ittalopezzotti/ittalopezzotti.copagetec.github.io/Img/Image_Copagetec_Closed_System_Conceptual_Idea.png

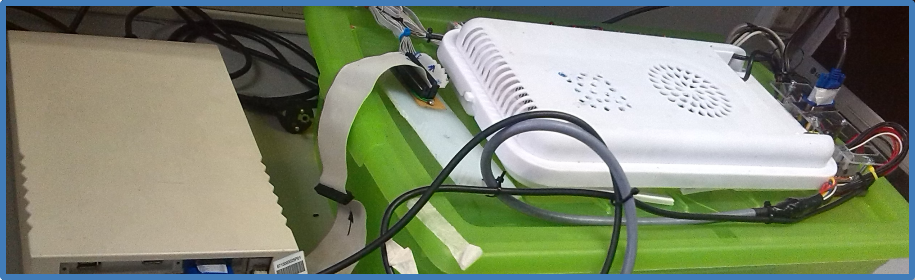
Img/Image_Copagetec_Closed_System_Conceptual_Idea.png
