ittalopezzotti/ittalopezzotti.copagetec.github.io/Img/Image_Copagetec_Conceptual_Proposal.png

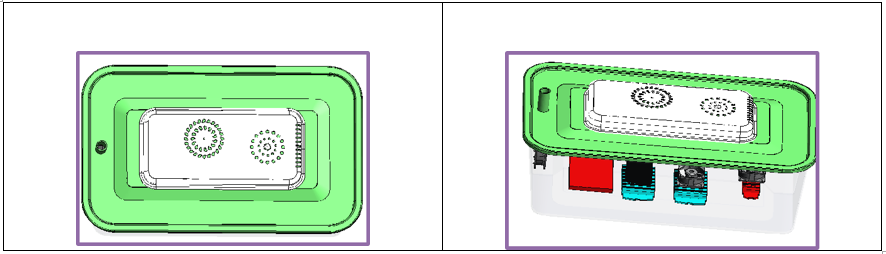
Img/Image_Copagetec_Conceptual_Proposal.png
