ittalopezzotti/ittalopezzotti.copagetec.github.io/Img/Image_Copagetec_Container_System_Elements .png

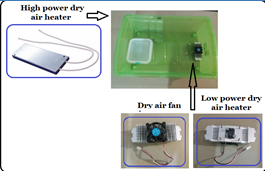
Img/Image_Copagetec_Container_System_Elements .png
