ittalopezzotti/ittalopezzotti.copagetec.github.io/Img/Image_Copagetec_Energy _Balance .png

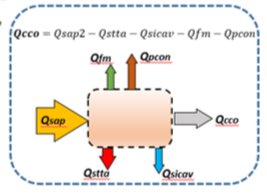
Img/Image_Copagetec_Energy _Balance .png
