ittalopezzotti/ittalopezzotti.copagetec.github.io/Img/Image_Copagetec_Table 3_Data_Relating_Conceptual_Idea.png

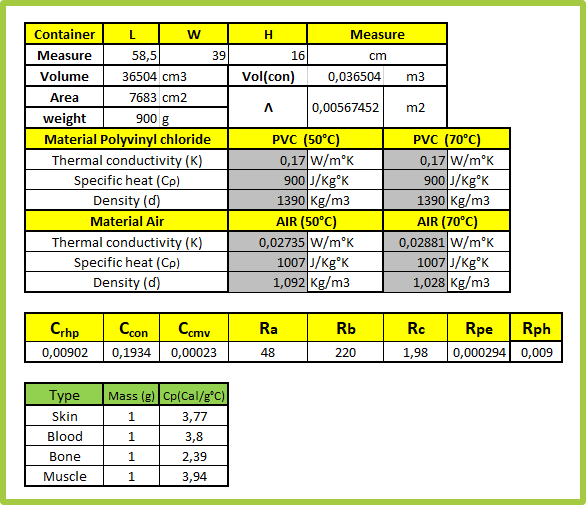
Img/Image_Copagetec_Table 3_Data_Relating_Conceptual_Idea.png
