ittalopezzotti/ittalopezzotti.copagetec.github.io/Img/Image_Copagetec_Transfer_functions .png

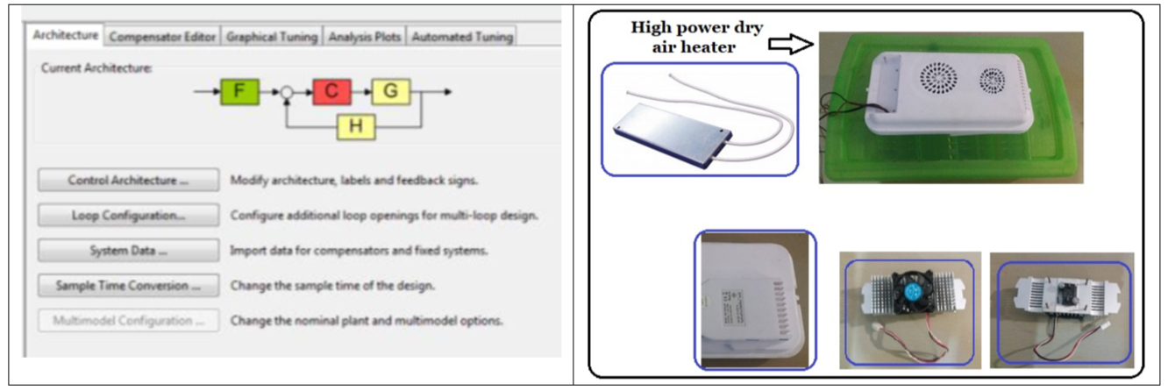
Img/Image_Copagetec_Transfer_functions .png
