ittalopezzotti/ittalopezzotti.copagetec.github.io/Img/Table_2_Teorical_Model.png

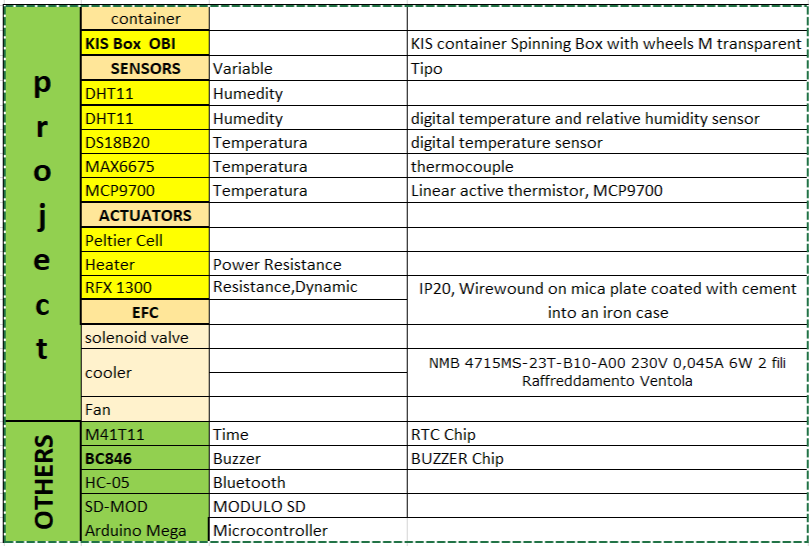
Img/Table_2_Teorical_Model.png
