ittalopezzotti/ittalopezzotti.copagetec.github.io/Eagle_Schematic_Copagetec_Project.pdf

## LEDS SYSTEM CONTROLLERREAL TIME CLOCK M41T11

# Eagle_Cacote_Copagetec.sch

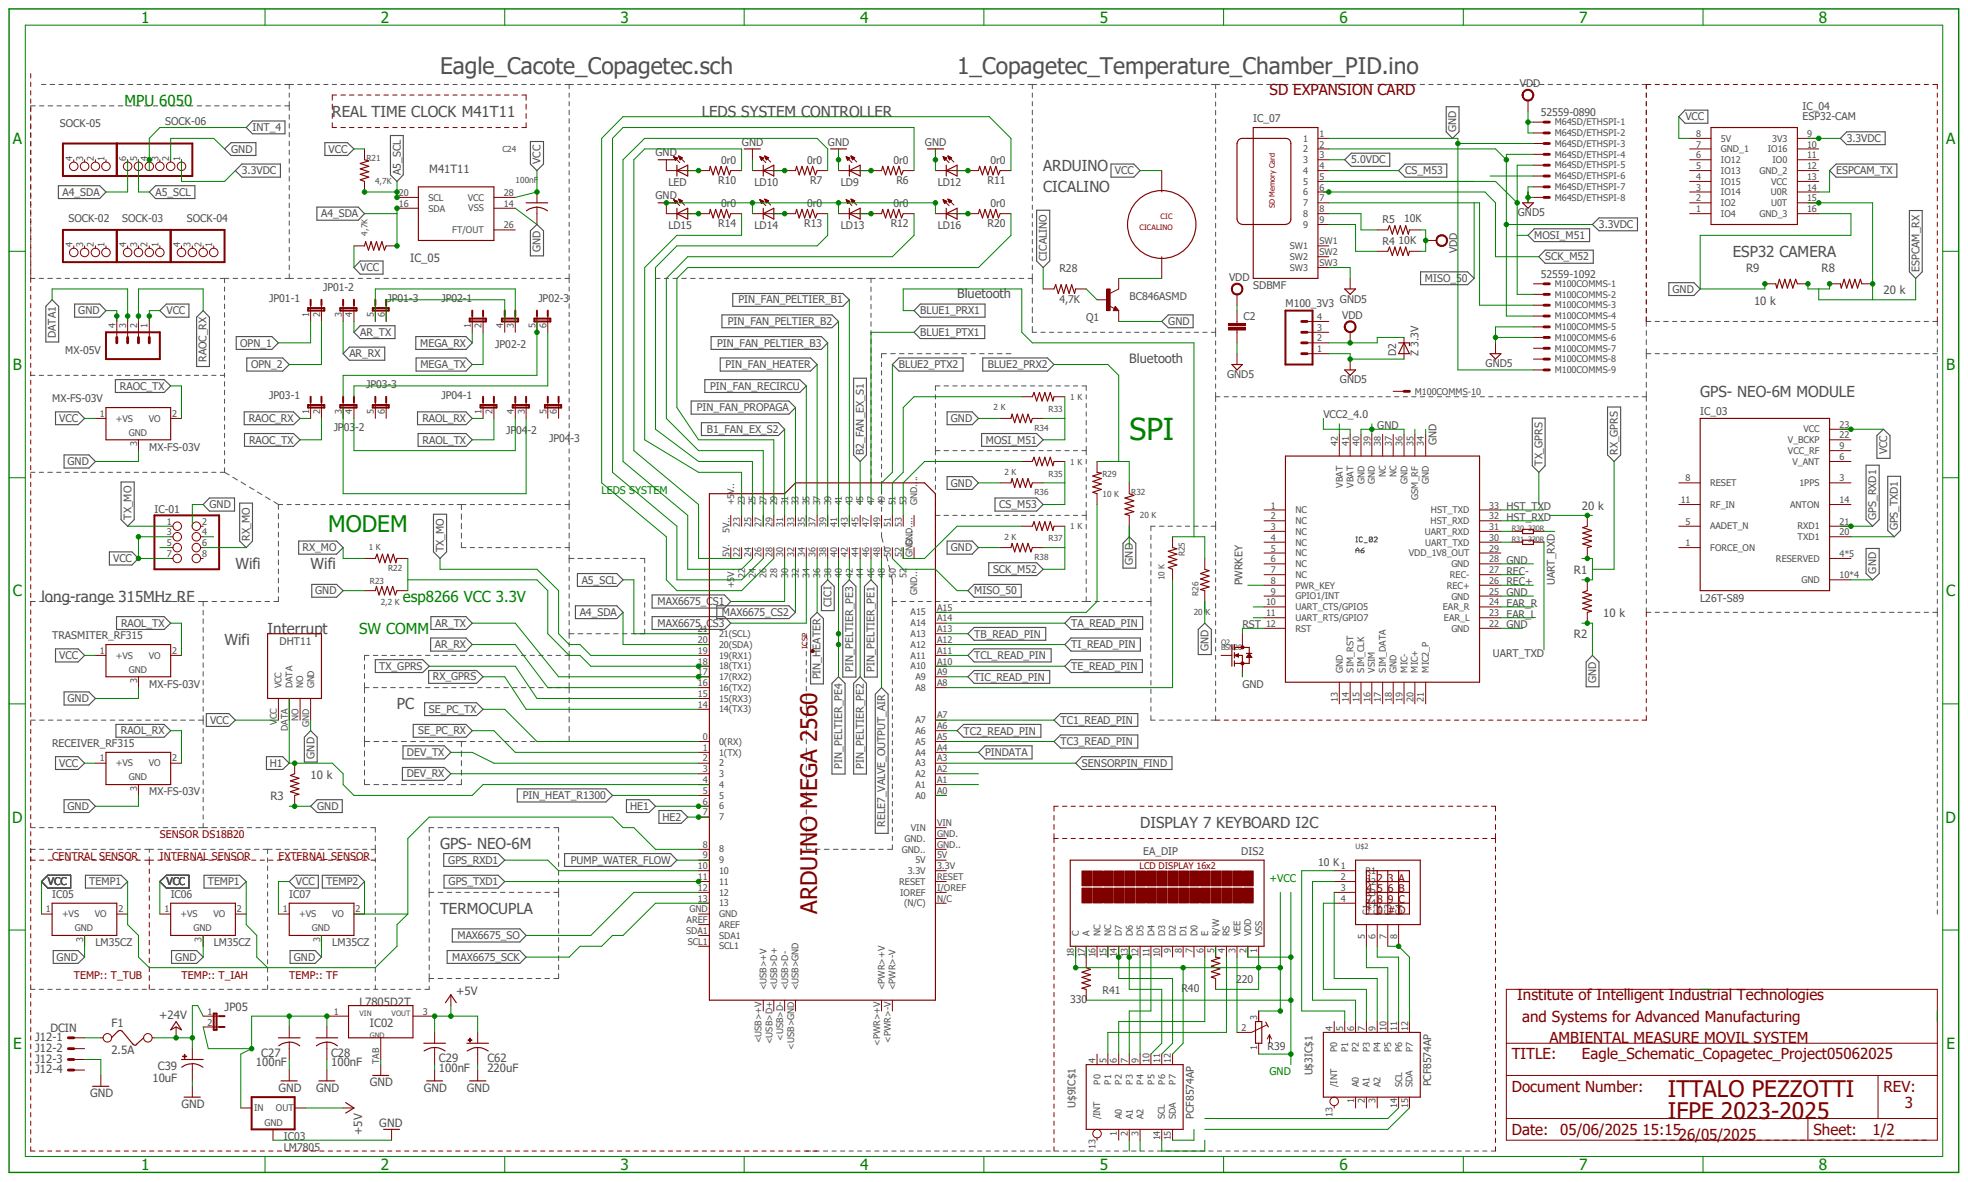
[picture p12: page 1]

Institute of Intelligent Industrial Technologies
and Systems for Advanced Manufacturing
AMBIENTAL MEASURE MOVIL SYSTEM

Document Number: ITTALO PEZZOTTI IFPE 2023-2025 | REV: 3

Date: 05/06/2025 15:15 26/05/2025 | Sheet: 1/2
