ittalopezzotti/ittalopezzotti.copagetec.github.io/Eagle_Schematic_Copagetec_Project.sch

## EAGLE design Eagle_Schematic_Copagetec_Project.sch (2025-06-05)

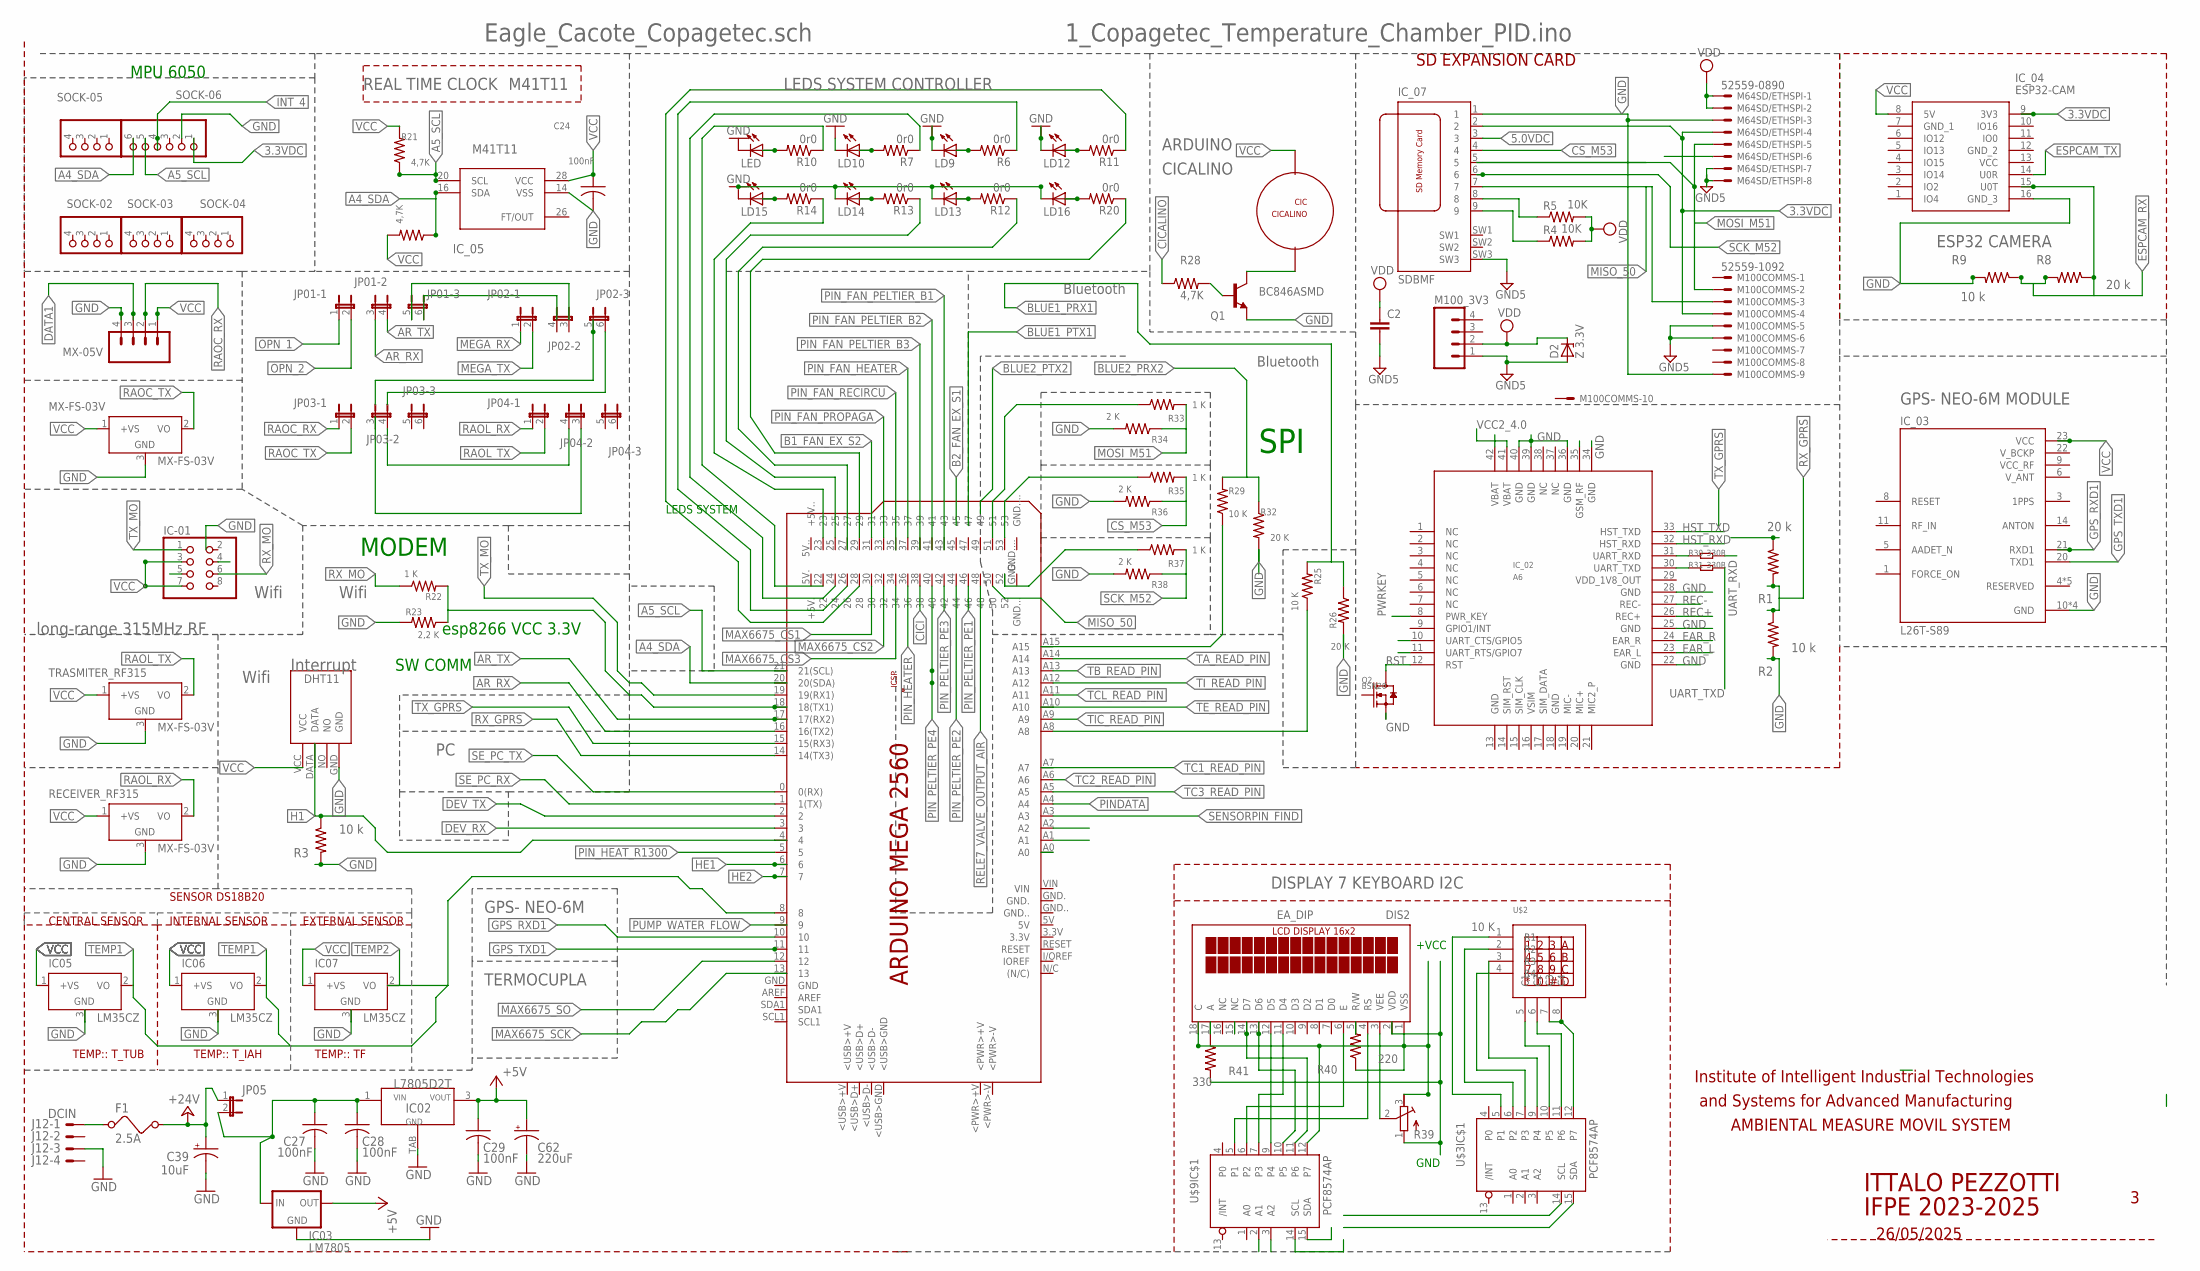
[picture p13: schematic Eagle_Schematic_Copagetec_Project.sch, sheet 1]

Parts:
C2: 100nF; C0805K@1
C24, C27, C28, C29: 100nF; C0805
C39: 10uF; C/6032-28R
C62: 220uF; 153CLV-0605
CICALINO: CIC
D2: Z 3.3V; SMB
DIS2: EA_DIP
F1: 2.5A; FUSE
IC02: L7805D2T; TO263-2
IC03: LM7805; 78XXS
IC05, IC06, IC07: LM35CZ; TO92
IC-01: PINHD-2X4; 2X04
IC_02: A6
IC_03: L26T-S89; XCVR_L26T-S89
IC_04: ESP32-CAM
IC_05: M41T11; SOH28
IC_07: SDBMF; SDBMF-009XXBXX2
J12: DCIN; PANDUIT_2.54X4
JP01, JP02, JP03, JP04: JP3QE; JP3Q
JP05: JP1E; JP1
LD9, LD10, LD12, LD13, LD14, LD15, LD16: LED3MM
LED: LED3MM
M64SD/ETHSPI: 52559-0890
M100COMMS: 52559-1092
M100_3V3: M04; 04P
MX-05V: M04; 04P
MX-FS-03V: MX-FS-03V; TO92
PCB1: ARDUINO_MEGA2560
Q1: BC846ASMD; SOT23
Q2: BSN20; SOT23@1
R1, R8: 20 k; M0805
R2, R3, R9: 10 k; M0805
R4, R5: 10K; M0805
R6, R7, R10, R11, R12, R13, R14, R20: 0r0; M0805
R21, R27, R28: 4,7K; M0805
R22, R33, R35, R37: 1 K; M0805
R23: 2,2 K; M0805
R25, R29: 10 K; M0805
R26, R32: 20 K; M0805
R30, R31: 330R; R0603
R34, R36, R38: 2 K; M0805
R39: 10 K; RTRIM64W
R40: 220; 0309/10
R41: 330; 0309/10
RECEIVER_RF315: MX-FS-03V; TO92
SOCK-02, SOCK-03, SOCK-04, SOCK-05: PINHD-1X4; 1X04
SOCK-06: PINHD-1X6_2.00; 1X06M
TRASMITER_RF315: MX-FS-03V; TO92
U$2: KEYPAD4X4
U$3, U$9: PCF8574AP; DIL16
U$12: DHT11

Connections:
3.3VDC: IC_04.9 (3V3), IC_07.2, M64SD/ETHSPI.4, M100COMMS.4, SOCK-06.1
5.0VDC: IC_07.3
+5V: C29.1, C62.+, IC02.3 (VOUT), IC03.OUT
+24V: C39.+, F1.2, JP05.1
A4_SDA: IC_05.16 (SDA), PCB1.20 (20(SDA)), R27.1, SOCK-06.6
A5_SCL: IC_05.20 (SCL), PCB1.21 (21(SCL)), R21.1, SOCK-06.5
ARME_M51: R33.1
ARME_M52: PCB1.52, R37.1
ARME_M53: R35.1
AR_RX: JP01.3 (1), PCB1.16 (16(TX2))
AR_TX: JP01.4 (2), PCB1.17 (17(RX2))
BLUE1_PRX1: R25.2, R26.1
BLUE2_PRX2: R29.2, R32.1
CICALINO: R28.1
CS_M53: IC_07.4, R35.2, R36.1
DATA1: MX-05V.3
DEV_RX: PCB1.3
DEV_TX: PCB1.2
EAR_L: IC_02.23 (EAR_L)
EAR_R: IC_02.24 (EAR_R)
ESPCAM_RX: IC_04.15 (U0T), R8.1, R8.2, R9.1
ESPCAM_TX: IC_04.14 (U0R)
GND: C24.2, C27.2, C28.2, C29.2, C39.-, C62.-, IC02.TAB (GND), IC03.GND, IC05.3 (GND), IC06.3 (GND), IC07.3 (GND), IC_02.22 (GND), IC_02.25 (GND), IC_02.28 (GND), IC_02.34 (GND), IC_02.36 (GND), IC_02.39 (GND), IC_02.40 (GND), IC_03.10 (GND), IC_04.16 (GND_3), IC_05.14 (VSS), IC_07.1, J12.3, LD10.K (C), LD15.K (C), LED.K (C), M64SD/ETHSPI.3, M100COMMS.9, MX-05V.4, MX-FS-03V.3 (GND), Q1.2 (E), Q2.2 (S), R9.2, R23.2, R26.2, R32.2, RECEIVER_RF315.3 (GND), SOCK-06.2, TRASMITER_RF315.3 (GND), U$12.GND
GND5: C2.2, D2.A, IC_07.SW3, M64SD/ETHSPI.7, M64SD/ETHSPI.8, M100COMMS.5, M100COMMS.6, M100_3V3.1
GPS_RXD1: IC_03.21 (RXD1), PCB1.10
GPS_TXD1: IC_03.20 (TXD1), PCB1.11
GSM_RF: IC_02.35 (GSM_RF)
H1: PCB1.4, R3.1, U$12.DATA
HE1: PCB1.6
HE2: PCB1.7
HST_RXD: IC_02.32 (HST_RXD)
HST_TXD: IC_02.33 (HST_TXD)
INT_4: SOCK-06.4
MAX6675_SCK: PCB1.13
MAX6675_SO: PCB1.12
MEGA_RX: JP02.1
MEGA_TX: JP02.2
MISO_50: IC_07.7, M100COMMS.3
MOSI_M51: M64SD/ETHSPI.5, M100COMMS.2, R33.2, R34.1
unnamed: F1.1, J12.1
unnamed: IC_02.31 (UART_RXD), R30.1
unnamed: IC_02.30 (UART_TXD), R31.1
unnamed: R1.2, R2.1
unnamed: IC_07.8, R5.1
unnamed: IC_07.9, R4.1
unnamed: Q1.1 (B), R28.2
unnamed: LD9.A, R6.2
unnamed: CICALINO.P$1, Q1.3 (C)
unnamed: LD10.A, R7.2
unnamed: LED.A, R10.2
unnamed: LD12.A, R11.2
unnamed: LD13.A, R12.2
unnamed: PCB1.27, R12.1
unnamed: JP03.4 (2), JP04.4 (2)
unnamed: JP03.3 (1), JP04.3 (1)
unnamed: U$2.7 (C3), U$2.8 (C4), U$3.12 (P7)
unnamed: U$2.6 (C2), U$3.11 (P6)
unnamed: U$2.5 (C1), U$3.10 (P5)
unnamed: U$2.3 (R3), U$3.9 (P4)
unnamed: U$2.4 (R4), U$3.7 (P3)
unnamed: U$2.2 (R2), U$3.6 (P2)
unnamed: U$2.1 (R1), U$3.5 (P1)
unnamed: LD14.A, R13.2
unnamed: LD15.A, R14.2
unnamed: LD16.A, R20.2
unnamed: DIS2.13 (D6), U$9.10 (P5)
unnamed: DIS2.3 (VEE), R39.2 (S)
unnamed: DIS2.14 (D7), U$9.11 (P6)
unnamed: DIS2.4 (RS), U$9.5 (P1)
unnamed: DIS2.5 (R/W), R40.2
unnamed: DIS2.11 (D4), U$9.7 (P3)
unnamed: DIS2.12 (D5), U$9.9 (P4)
unnamed: DIS2.17 (A), R41.1
unnamed: DIS2.1 (VSS), DIS2.18 (C), R39.3 (E), R40.1, U$9.12 (P7)
unnamed: DIS2.2 (VDD), R39.1 (A), R41.2
unnamed: DIS2.6 (E), U$9.6 (P2)
unnamed: LD9.K (C), LD12.K (C), LD13.K (C), LD14.K (C), LD16.K (C)
unnamed: C27.1, C28.1, IC02.1 (VIN), IC03.IN, JP05.2
OPN_1: JP01.1
OPN_2: JP01.2
PINDATA: PCB1.A4
PIN_FAN_PELTIER_B1: PCB1.43
PIN_FAN_PELTIER_B2: PCB1.41
PIN_FAN_PELTIER_B3: PCB1.39
PIN_FAN_RECIRCU: PCB1.35
PIN_HEAT_R1300: PCB1.5
PIN_PELTIER_PE4: PCB1.GND__, PCB1.RESET.
PWRKEY: IC_02.8 (PWR_KEY)
RAOC_RX: JP03.1, MX-05V.2
RAOC_TX: JP03.2, MX-FS-03V.2 (VO)
RAOL_RX: JP04.1, RECEIVER_RF315.2 (VO)
RAOL_TX: JP04.2, TRASMITER_RF315.2 (VO)
REC+: IC_02.26 (REC+)
REC-: IC_02.27 (REC-)
RST: IC_02.12 (RST), Q2.3 (D)
RX_GPRS: PCB1.14 (14(TX3))
RX_MO: IC-01.6, R22.1
RX_MO1: PCB1.A8, R25.1
RX_MO2: PCB1.A15, R29.1
SCK_M52: IC_07.6, R37.2, R38.1
SENSORPIN_FIND: PCB1.A3
SE_PC_RX: PCB1.1 (1(TX))
SE_PC_TX: PCB1.0 (0(RX))
TA_READ_PIN: PCB1.A14
TB_READ_PIN: PCB1.A13
TC1_READ_PIN: PCB1.A7
TC2_READ_PIN: PCB1.A6
TC3_READ_PIN: PCB1.A5
TCL_READ_PIN: PCB1.A11
TEMP1: IC05.2 (VO), IC06.2 (VO), PCB1.8
TEMP2: IC07.2 (VO)
TE_READ_PIN: PCB1.A10
TIC_READ_PIN: PCB1.A9
TI_READ_PIN: PCB1.A12
TX1_ARMEGA: PCB1.18 (18(TX1)), R22.2, R23.1
TX_GPRS: PCB1.15 (15(RX3))
TX_MO: IC-01.1, PCB1.19 (19(RX1))
UART_CTS: IC_02.10 (UART_CTS/GPIO5)
UART_RTS: IC_02.11 (UART_RTS/GPIO7)
UART_RXD: R30.2
UART_TXD: R31.2
VCC: C24.1, CICALINO.P$2, IC05.1 (+VS), IC06.1 (+VS), IC07.1 (+VS), IC-01.3, IC-01.7, IC_03.23 (VCC), IC_04.8 (5V), IC_05.28 (VCC), MX-05V.1, MX-FS-03V.1 (+VS), R21.2, R27.2, RECEIVER_RF315.1 (+VS), TRASMITER_RF315.1 (+VS), U$12.VCC
VCC2_4.0: IC_02.41 (VBAT), IC_02.42 (VBAT)
VDD: C2.1, D2.C, M64SD/ETHSPI.1, M64SD/ETHSPI.2, M100_3V3.2, R4.2, R5.2

Notes on the sheet:
SW COMM
Institute of Intelligent Industrial Technologies
IFPE 2023-2025
AMBIENTAL MEASURE MOVIL SYSTEM
and Systems for Advanced Manufacturing
26/05/2025
ITTALO PEZZOTTI
ESP32 CAMERA
MPU 6050
SD EXPANSION CARD
SPI
GPS- NEO-6M MODULE
GPS- NEO-6M
TERMOCUPLA
Interrupt
Wifi
Bluetooth
LEDS SYSTEM
MODEM
esp8266 VCC 3.3V
LEDS SYSTEM CONTROLLER
REAL TIME CLOCK
M41T11
Eagle_Cacote_Copagetec.sch
CICALINO
ARDUINO
+VCC
GND
DISPLAY 7 KEYBOARD I2C
long-range 315MHz RF
EXTERNAL SENSOR
INTERNAL SENSOR
CENTRAL SENSOR
SENSOR DS18B20
1_Copagetec_Temperature_Chamber_PID.ino
TEMP:: T_TUB
TEMP:: T_IAH
TEMP:: TF

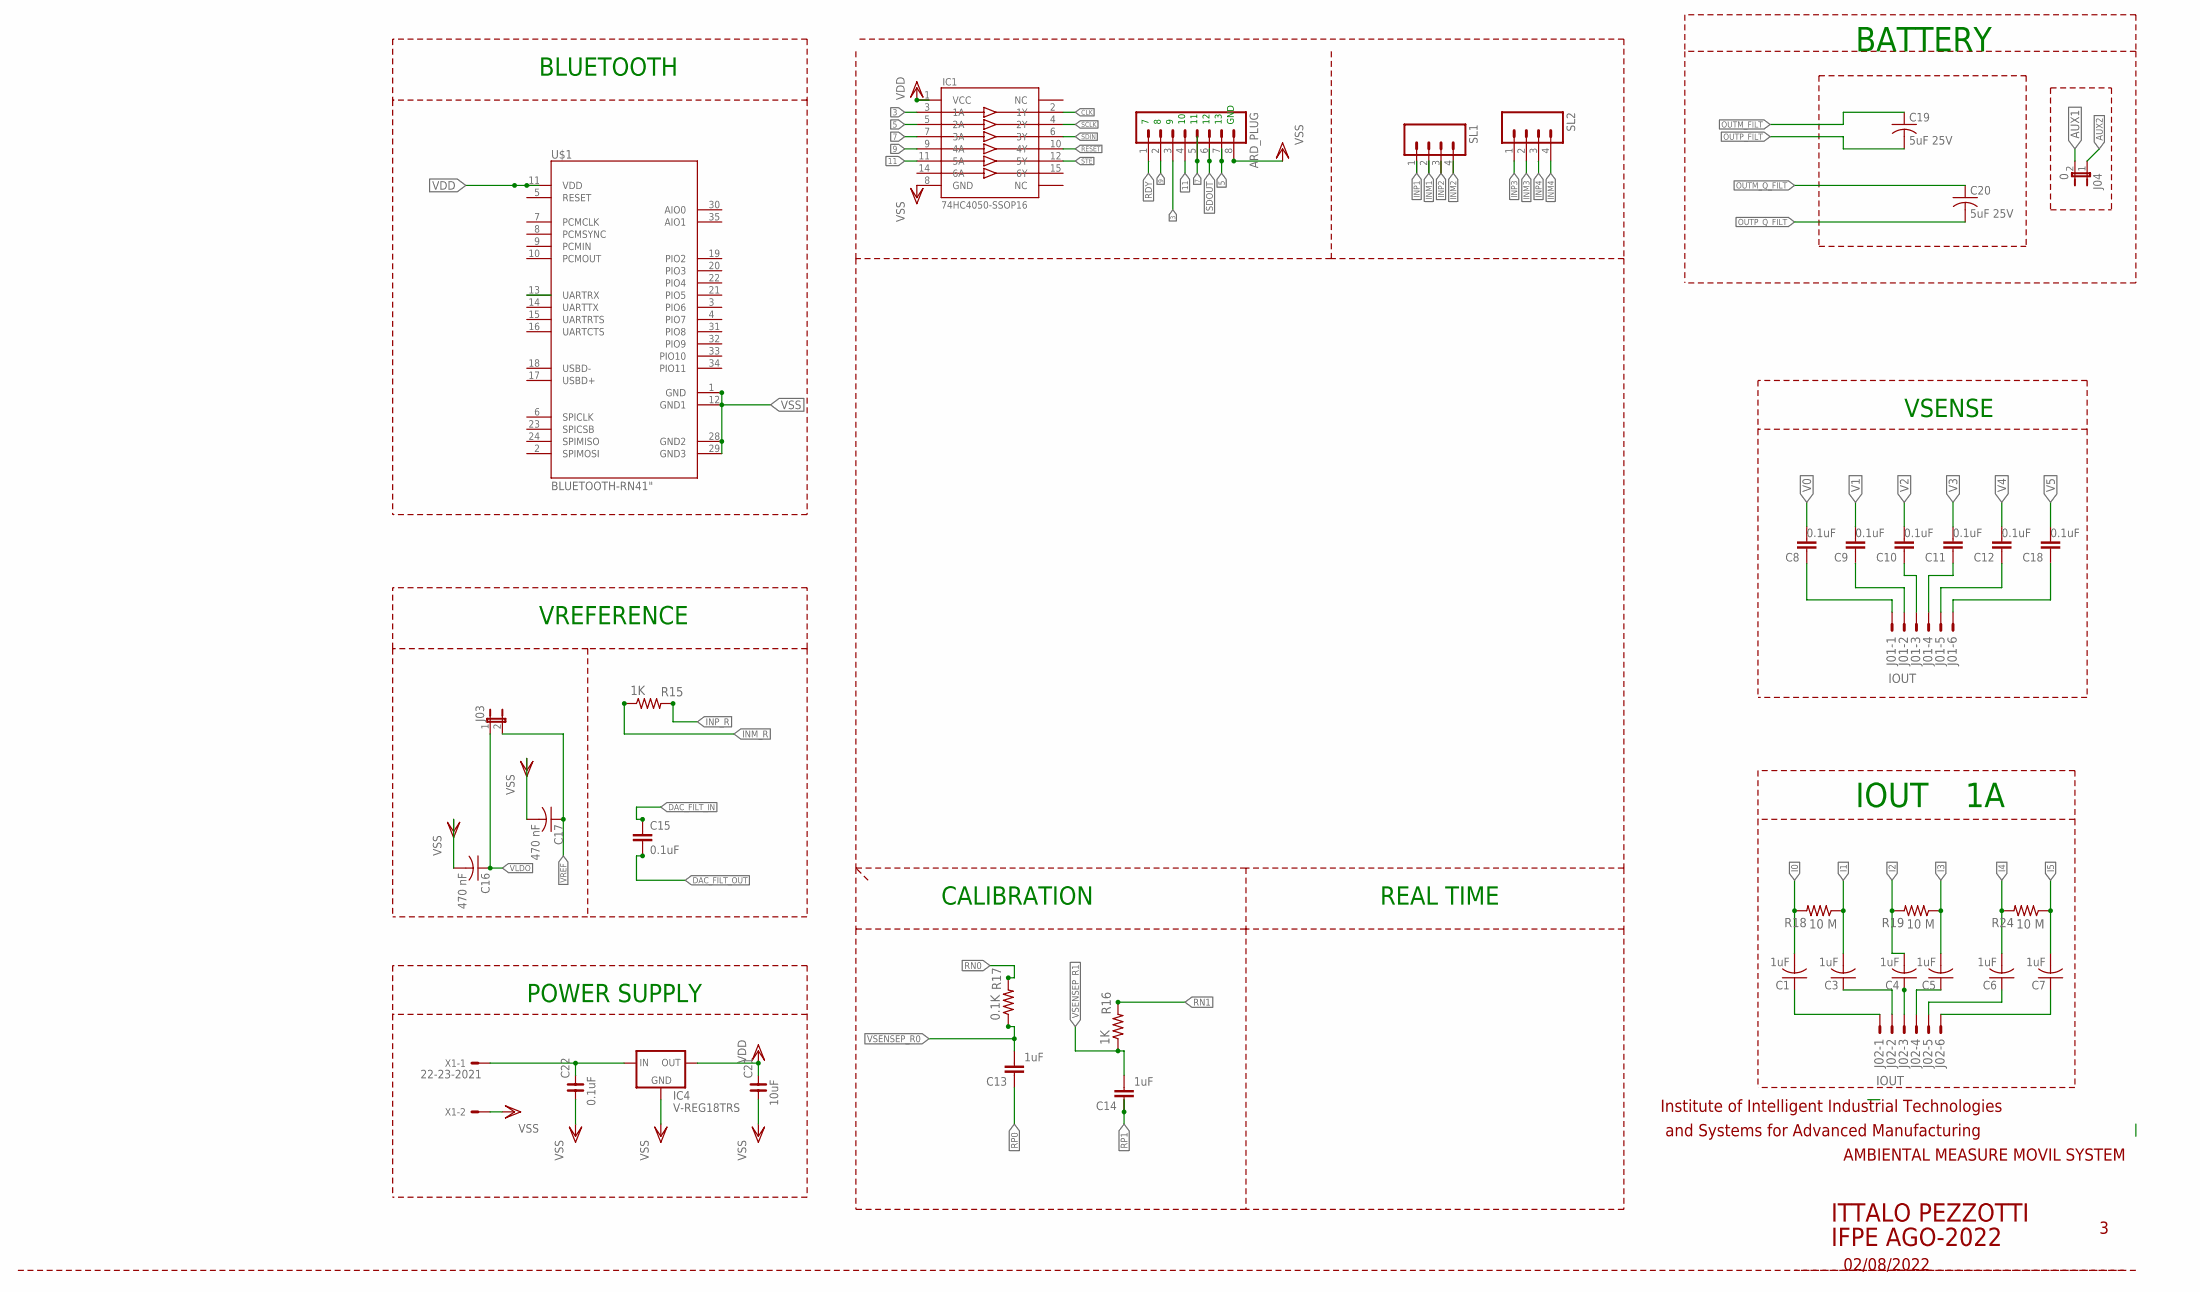
[picture p14: schematic Eagle_Schematic_Copagetec_Project.sch, sheet 2]

Parts:
ARD_PLUG: 08P
C1, C3, C4, C5, C6, C7: 1uF; C2012
C8, C9, C10, C11, C12, C15, C18: 0.1uF; C0805K@1
C13, C14: 1uF; C0805K@1
C16, C17: 470 nF; C2012
C19, C20: 5uF 25V; C2012
C21: 10uF; C1206
C22: 0.1uF; C0805
IC1: 74HC4050-SSOP16; TSSOP16
IC4: V-REG18TRS; SOT223
J01, J02: IOUT; PANDUIT_2.54X6
J03: JP1
J04: 0; JP1
R15, R16: 1K; M0805
R17: 0.1K; M0805
R18, R19, R24: 10 M; M0805
SL1, SL2: M04; 04P
U$1: BLUETOOTH-RN41"; RN41
X1: 22-23-2021

Connections:
3: ARD_PLUG.3, IC1.3 (1A)
5: ARD_PLUG.7, IC1.5 (2A)
7: ARD_PLUG.5, IC1.7 (3A)
9: ARD_PLUG.2, IC1.9 (4A)
11: ARD_PLUG.4, IC1.11 (5A)
AUX1: J04.2
AUX2: J04.1
CLK: IC1.2 (1Y)
DAC_FILT_IN: C15.1
DAC_FILT_OUT: C15.2
I0: C1.2, R18.2
I1: C3.2, R18.1
I2: C4.2, R19.2
I3: C5.2, R19.1
I4: C6.2, R24.2
I5: C7.2, R24.1
INM1: SL1.2
INM2: SL1.4
INM3: SL2.2
INM4: SL2.4
INM_R: R15.1
INP1: SL1.1
INP2: SL1.3
INP3: SL2.1
INP4: SL2.3
INP_R: R15.2
unnamed: C4.1, J02.3
unnamed: C5.1, J02.4
unnamed: C7.1, J02.6
unnamed: C3.1, J02.2
unnamed: C1.1, J02.1
unnamed: C6.1, J02.5
unnamed: C8.1, J01.1
unnamed: C9.1, J01.2
unnamed: C10.1, J01.3
unnamed: C11.1, J01.4
unnamed: C12.1, J01.5
unnamed: C18.1, J01.6
unnamed: C22.2, IC4.3 (IN), X1.1
OUTM_FILT: C19.1
OUTM_Q_FILT: C20.1
OUTP_FILT: C19.2
OUTP_Q_FILT: C20.2
RDY: ARD_PLUG.1
RESET: IC1.10 (4Y)
RN0: R17.2
RN1: R16.2
RP0: C13.1
RP1: C14.1
RX: U$1.13 (UARTRX)
SCLK: IC1.4 (2Y)
SDIN: IC1.6 (3Y)
SDOUT: ARD_PLUG.6
STE: IC1.12 (5Y)
V0: C8.2
V1: C9.2
V2: C10.2
V3: C11.2
V4: C12.2
V5: C18.2
VDD: C21.2, IC1.1 (VCC), IC4.4 (OUT), U$1.11 (VDD)
VLDO: C16.1, J03.1
VREF: C17.1, J03.2
VSENSEP_R0: C13.2, R17.1
VSENSEP_R1: C14.2, R16.1
VSS: ARD_PLUG.8, C16.2, C17.2, C21.1, C22.1, IC1.8 (GND), IC4.1 (GND), U$1.1 (GND), U$1.12 (GND1), U$1.28 (GND2), U$1.29 (GND3), X1.2

Notes on the sheet:
VSENSE
CALIBRATION
IOUT
BATTERY
GND
VREFERENCE
POWER SUPPLY
REAL TIME
BLUETOOTH
Institute of Intelligent Industrial Technologies
IFPE AGO-2022
AMBIENTAL MEASURE MOVIL SYSTEM
and Systems for Advanced Manufacturing
02/08/2022
ITTALO PEZZOTTI
