ittalopezzotti/ittalopezzotti.copagetec.github.io/(commit log)

2025-06-05 Add files via upload
    ABSTRACT
    The article's main objective is to show how the necessary parameters are calculated and obtained to build a non-pressurized closed chamber and generate thermal cycles for three temperature zones using a PID controller. The equations, the data table with the calculations, and the transfer functions of the proportional-integral-derivative (PID) control loop mechanism will be described.
    SourceCode
    • Teorical model of the CACOTE system
    https://ittalopezzotti.github.io/github.io.copagetec.teoricalmodel.github.io/
    • Mathematical model of the CACOTE system
    https://ittalopezzotti.github.io/github.io.copagetec.Mathematicalmodel.github.io/
    • Thermal or therm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
    [Eagle_Schematic_Copagetec_Project.sch]
2025-06-05 Add files via upload
    CALCULATION AND OBTAINING OF PARAMETERS TO GENERATE THERMAL CYCLES USING PID CONTROL IN A NON-PRESSURIZED CLOSED SYSTEM FOR MATERIALS TEST
2025-06-06 COPAGETEC PROJECT
    CALCULATION AND OBTAINING OF PARAMETERS TO GENERATE THERMAL CYCLES BY MEANS OF PID CONTROL IN A NON-PRESSURIZED CLOSED SYSTEM FOR MATERIALS TEST
